cibomahto/Missing/Hardware/delrin gear settings.PNG

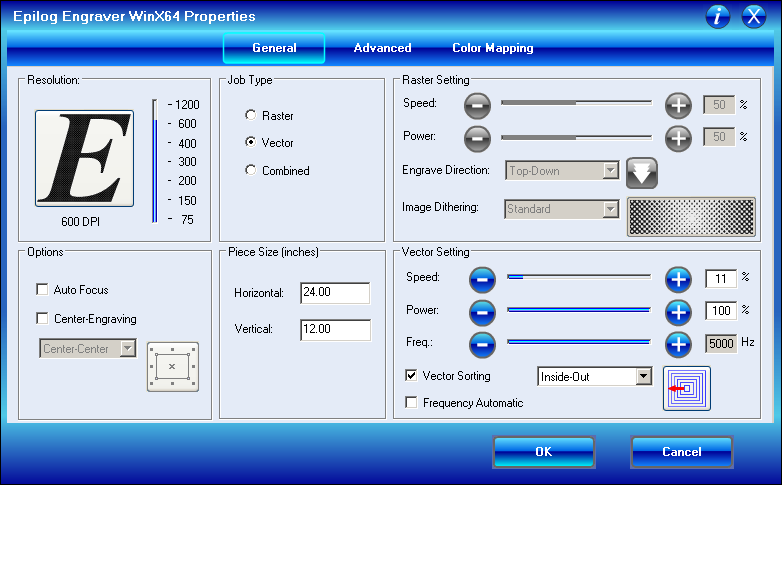
Hardware/delrin gear settings.PNG
