cibomahto/Missing/Hardware/triangle_mount_revB_grandlaser.pdf

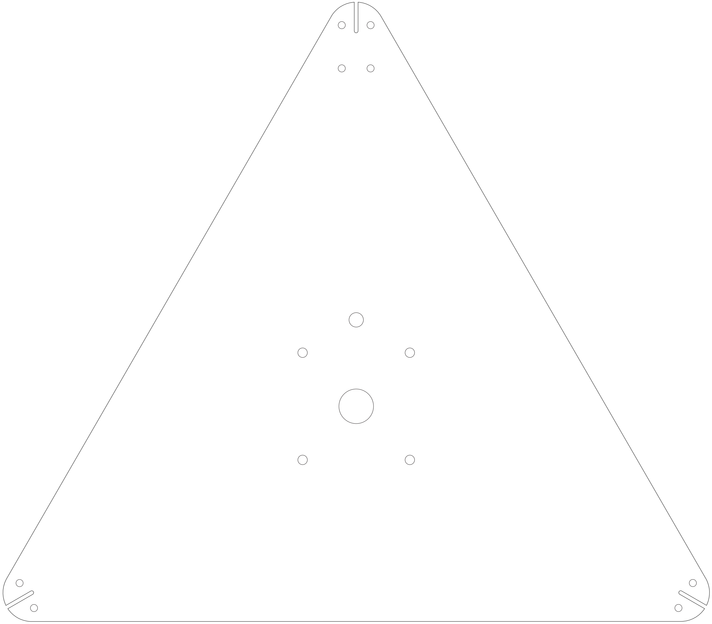
[picture p2: figure]
