cibomahto/Missing/motorControlPcb/motor control pcb stencil.pdf

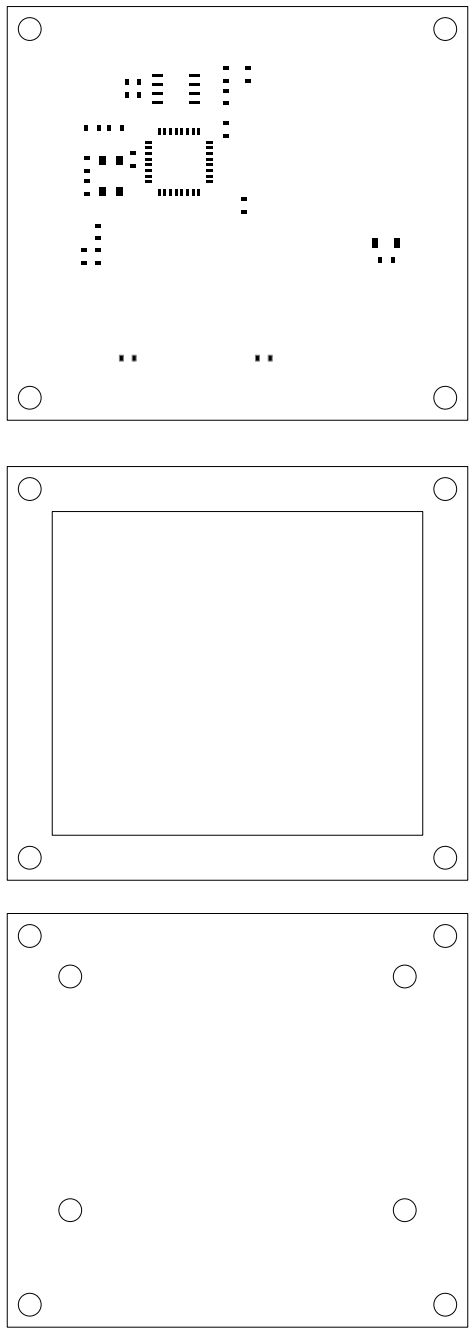
[picture p3: figure]
