cibomahto/Missing/Hardware/Concepts/Screen shot 2012-10-02 at 1.14.52 .png

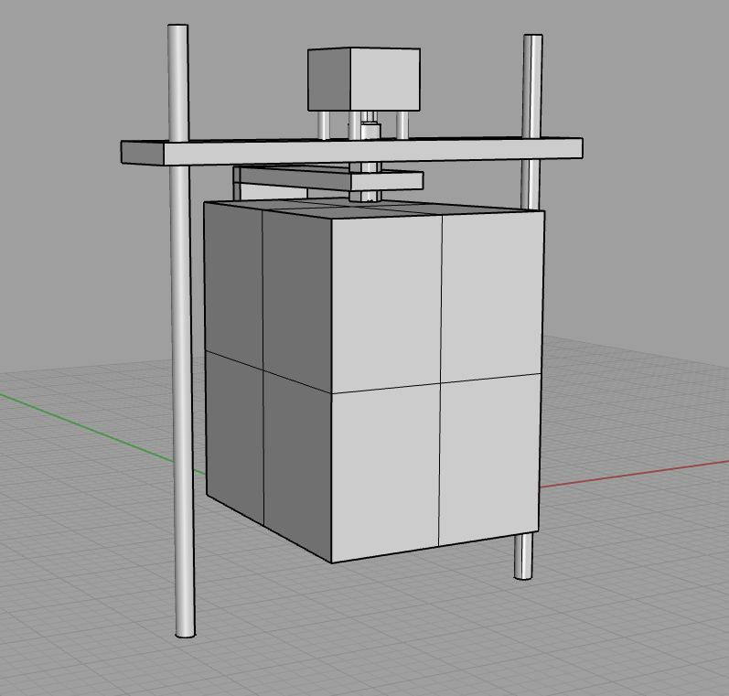
Hardware/Concepts/Screen shot 2012-10-02 at 1.14.52 .png
