cibomahto/Missing/Hardware/Concepts/Screen shot 2012-10-02 at 2.44.19 .png

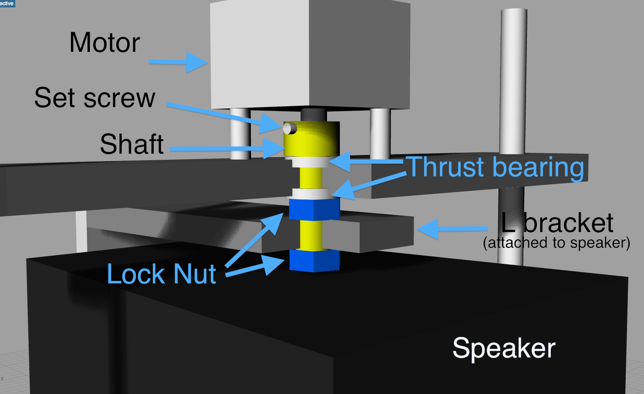
Hardware/Concepts/Screen shot 2012-10-02 at 2.44.19 .png
