cibomahto/Missing/Hardware/inventory.ods

Assembly | Part | per unit | total | Have?
Motor Unit | Stepper | 1 | 50 | Yes, 60 | x
 | Pot | 1 | 50 | Yes, 60 | x
 | Pot nut | 1 | 50 | Yes, 60 | x
 | Motor mount plate | 1 | 50 | Yes, 55+ | x
 | coupler | 1 | 50 | Yes, 60 | x
 | motor gear | 1 | 50 | Yes, 60 | x
 | pot gear | 1 | 50 | Yes, 60 | x
 | 8/32 standoff, 1” | 4 | 200 | Yes, 200+ | x
 | 8/32 bolt, .5” | 4 | 200 | Yes, 200+ | x
 | pot wire | 1 | 50 |  | x
 | pot heatshrink | 1 | 50 |  | x
 | stepper heatshrink | 1 | 50 |  | x
 | zip tie | 1 | 50 | Yes 90+ | x
 | M3x8, gear to standoff | 1 | 50 | Yes 50 | x
 | M3x8, standoff to shaft | 1 | 50 | 30 need 50 | x
 | M3x12, standoff to motor | 1 | 50 | Yes 50 | x
 | M3x6, PCB mount | 4 | 200 | Yes, 200+ | x
 | M3 nut, motor to plate | 2 | 100 | Yes, 100+ | x
 |  |  | 0
 |  |  | 0
 |  |  | 0
 |  |  | 0
Speaker Mount | Alignment plate | 2 | 100 | Yes, 102
 | wire clip | 6 | 300 | Yes, 320
 | M3x22, clip to plate | 6 | 300 | Yes, 400
 | bearing | 2 | 100 | Yes, 100+
 | M8 x 55mm, shaft | 1 | 50 | Yes, 50
 | 8/32 bolt, 1”, plate to motor standoff | 4 | 200 | Yes, 200+
 | 1/4-20, 3/4”, mechanical stop | 1 | 50 | Yes 50+
 | 1/2-20, lock nut, mechanical stop | 1 | 50 | Yes 50+
 | M3 nut, clip to plate | 6 | 300 | Yes 300
 |  |  | 0
 |  |  | 0
 |  |  | 0
 |  |  | 0
 |  |  | 0
 |  |  | 0
 |  |  | 0
 |  |  | 0
 |  |  | 0
L bracket | 1/4-20, 3/4”, speaker mount | 1 | 50 |  | x
 | M8 nut | 2 | 100 | Yes, 150+
 | M8 washer | 2 | 100 | Yes, 100+
 | M3x12, speaker alignment | 2 | 100 | Yes 100+ | x
 | M3 nut, speaker alignment | 2 | 100 | Yes 100 | x
 | 1/4-20, 3/4”, mechanical stop | 1 | 50 | no need 50 | x
 | 1/2-20, lock nut, mechanical stop | 1 | 50 | Have 40 need 20 more | x
 |  |  | 0
 |  |  | 0
 |  |  | 0
 |  |  | 0
 |  |  | 0
 |  |  | 0
 |  |  | 0
