cibomahto/Missing/Hardware/Concepts/standoff.stl

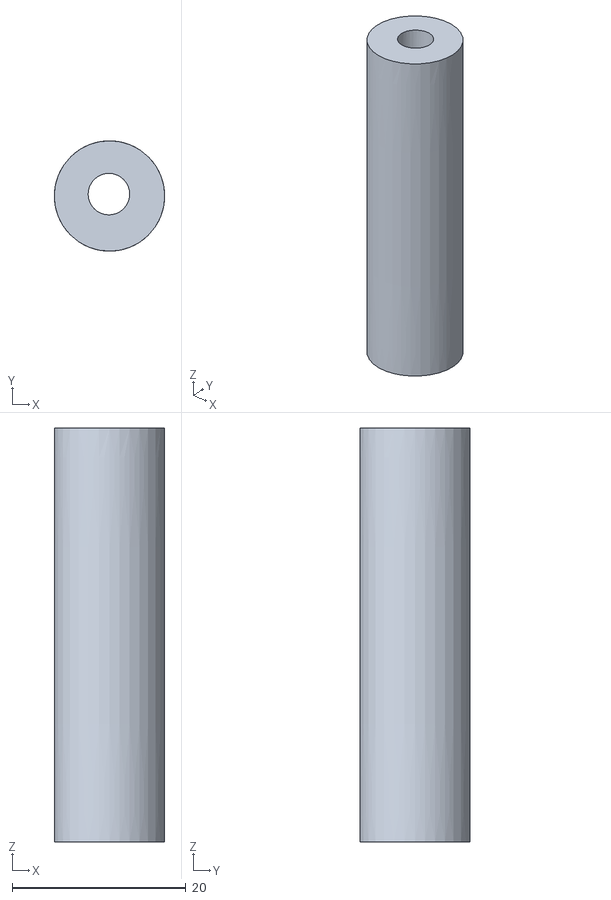
[picture p7: CAD file, 2012-11-15]
Hardware/Concepts/standoff.stl
12.7 x 12.7 x 47.6
