cibomahto/Missing/Hardware/Concepts/motor mount.stl

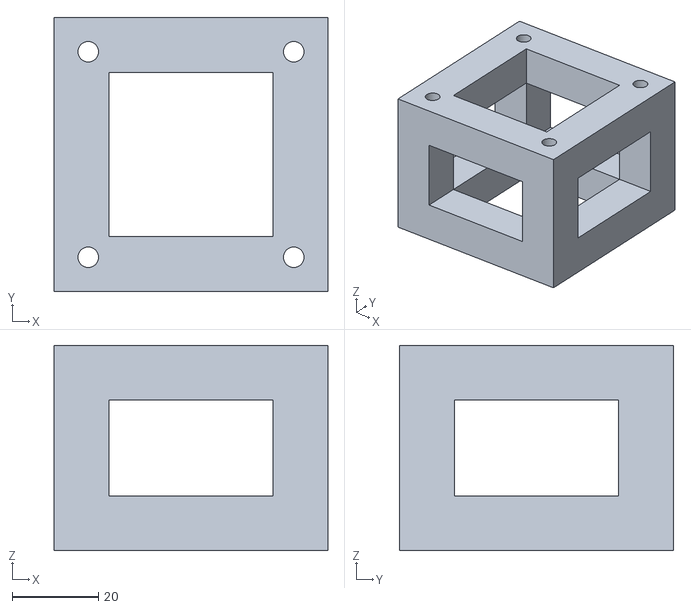
[picture p8: CAD file, 2012-10-04]
Hardware/Concepts/motor mount.stl
63.5 x 63.5 x 47.6
