cibomahto/Missing/MissingApp/bin/data/play3.obj

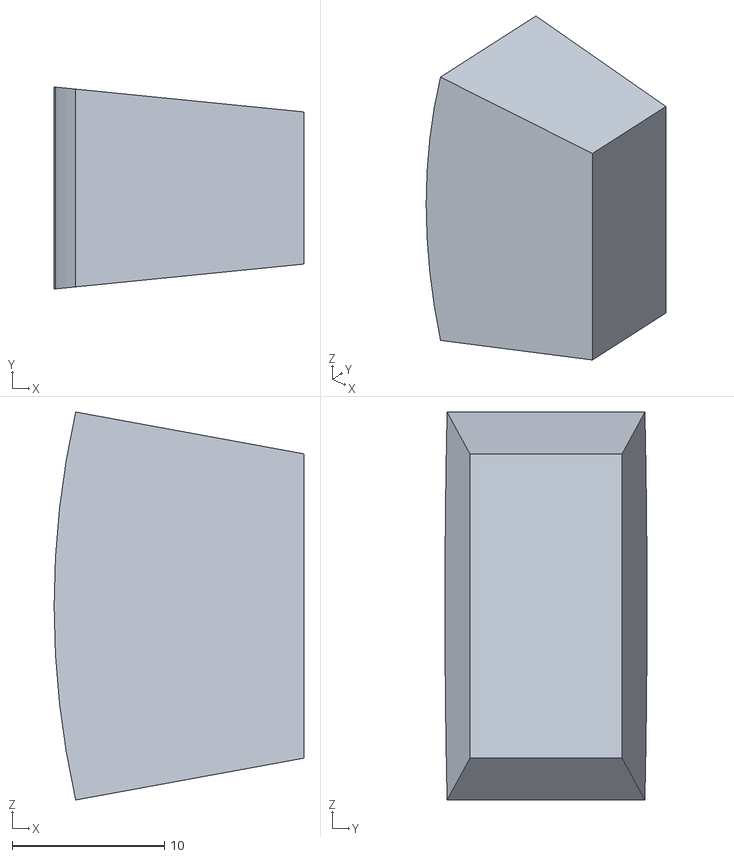
[picture p9: CAD file, 2012-11-11]
MissingApp/bin/data/play3.obj
16.4 x 13.3 x 25.5
