cibomahto/Missing/Hardware/Concepts/stepper_connector.stl

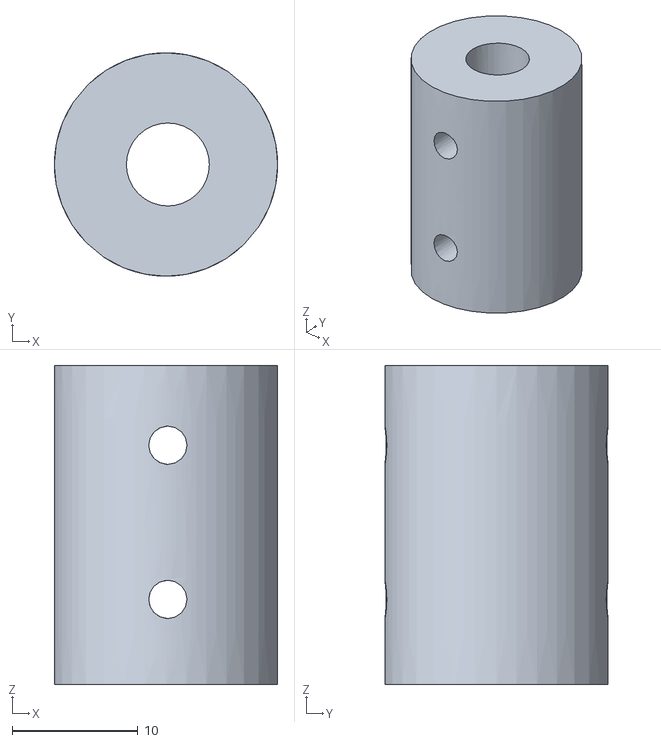
[picture p10: CAD file, 2012-10-04]
Hardware/Concepts/stepper_connector.stl
17.8 x 17.8 x 25.4
