cibomahto/Missing/(list of files, cad)

Other CAD files:
MissingApp/bin/data/centers.ply
MissingApp/bin/data/wires.ply
Hardware/Concepts/motor mount.3dm
Hardware/Concepts/sonos_speaker_mount.3dm
Hardware/Concepts/standoff.3dm
Hardware/Concepts/stepper_connector.3dm
Hardware/play3.3dm
Hardware/speaker_assembly.3dm
Hardware/triangle_mount.3dm
