cibomahto/Missing/Hardware/l_bracket_dimensions.pdf

# Sonos Speaker Mount Rev A - 10/13/2012

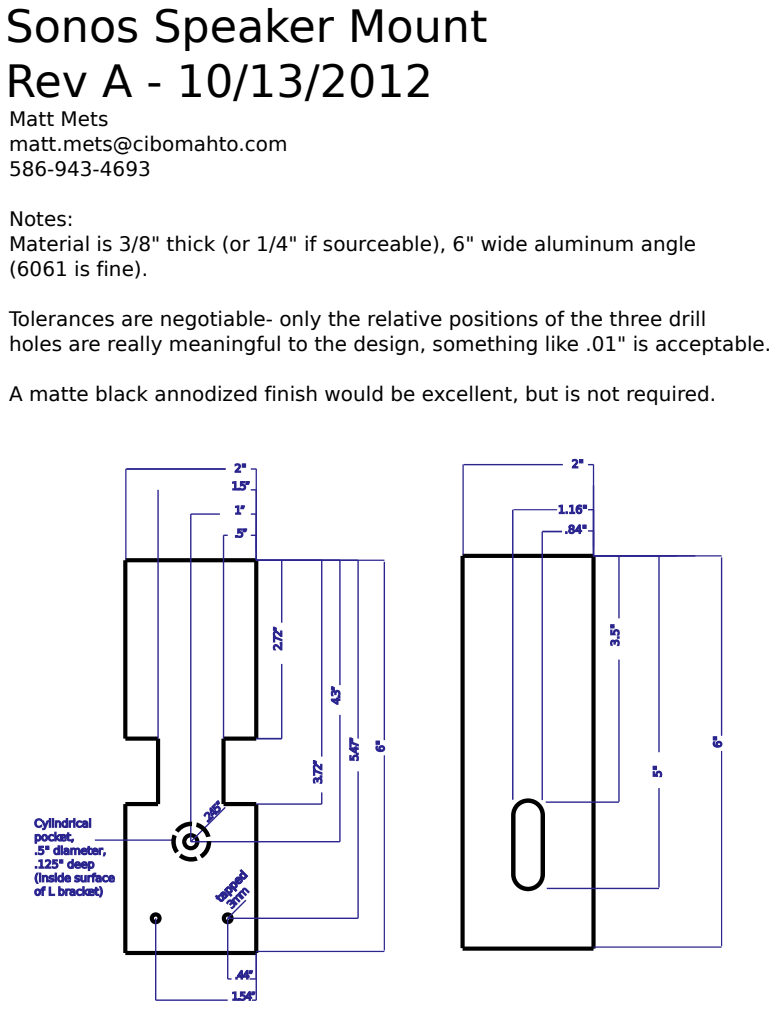
[picture p11: page 1]
Cylindrical pocket, .5" diameter, .125" deep (inside surface of L bracket)

Matt Mets
matt.mets@cibomahto.com

Notes:
Material is 3/8" thick (or 1/4" if sourceable), 6" wide aluminum angle
(6061 is fine).

Tolerances are negotiable- only the relative positions of the three drill
holes are really meaningful to the design, something like .01" is acceptable.

A matte black annodized finish would be excellent, but is not required.
