cibomahto/Missing/powerDistributionPcb/power distribution pcb stencil.pdf

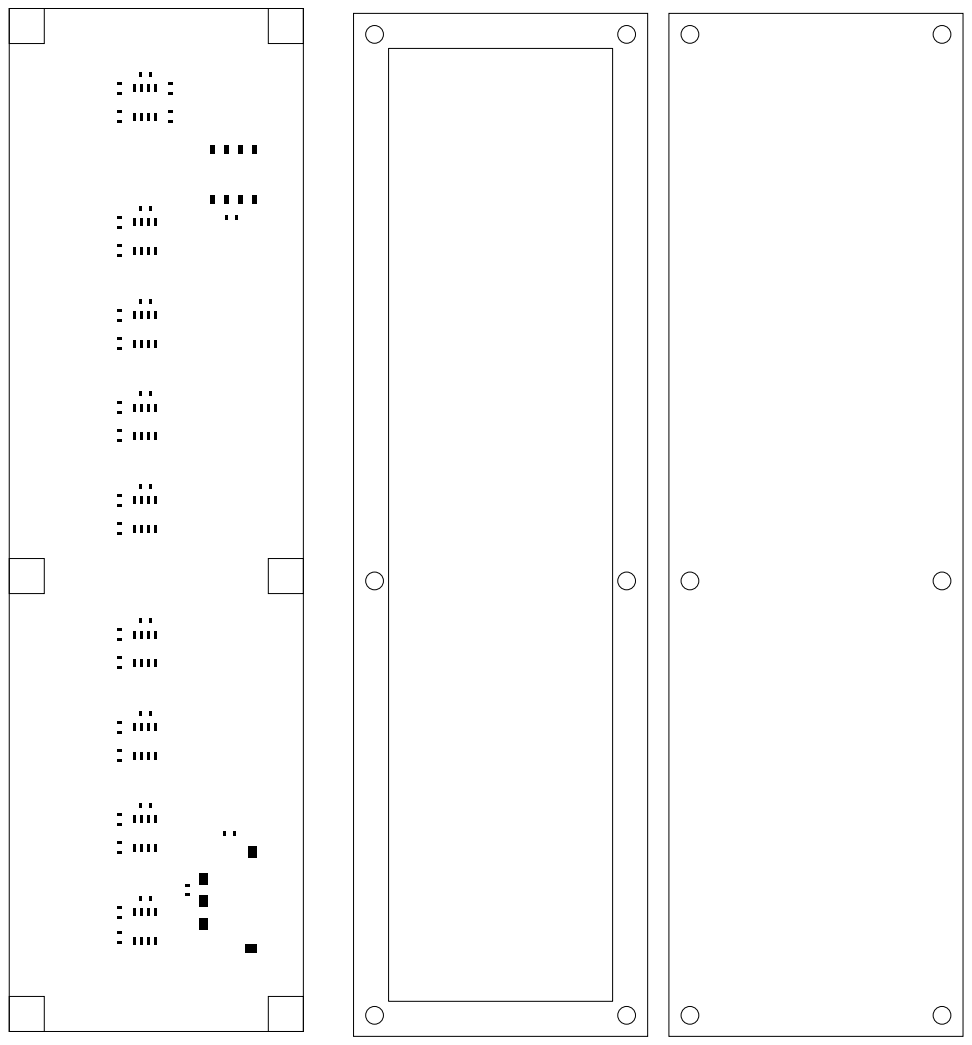
[picture p12: page 1]
