cibomahto/Missing/motorControlPcb/motor control pcb.brd

## EAGLE design motorControlPcb/motor control pcb.brd (2012-10-21)

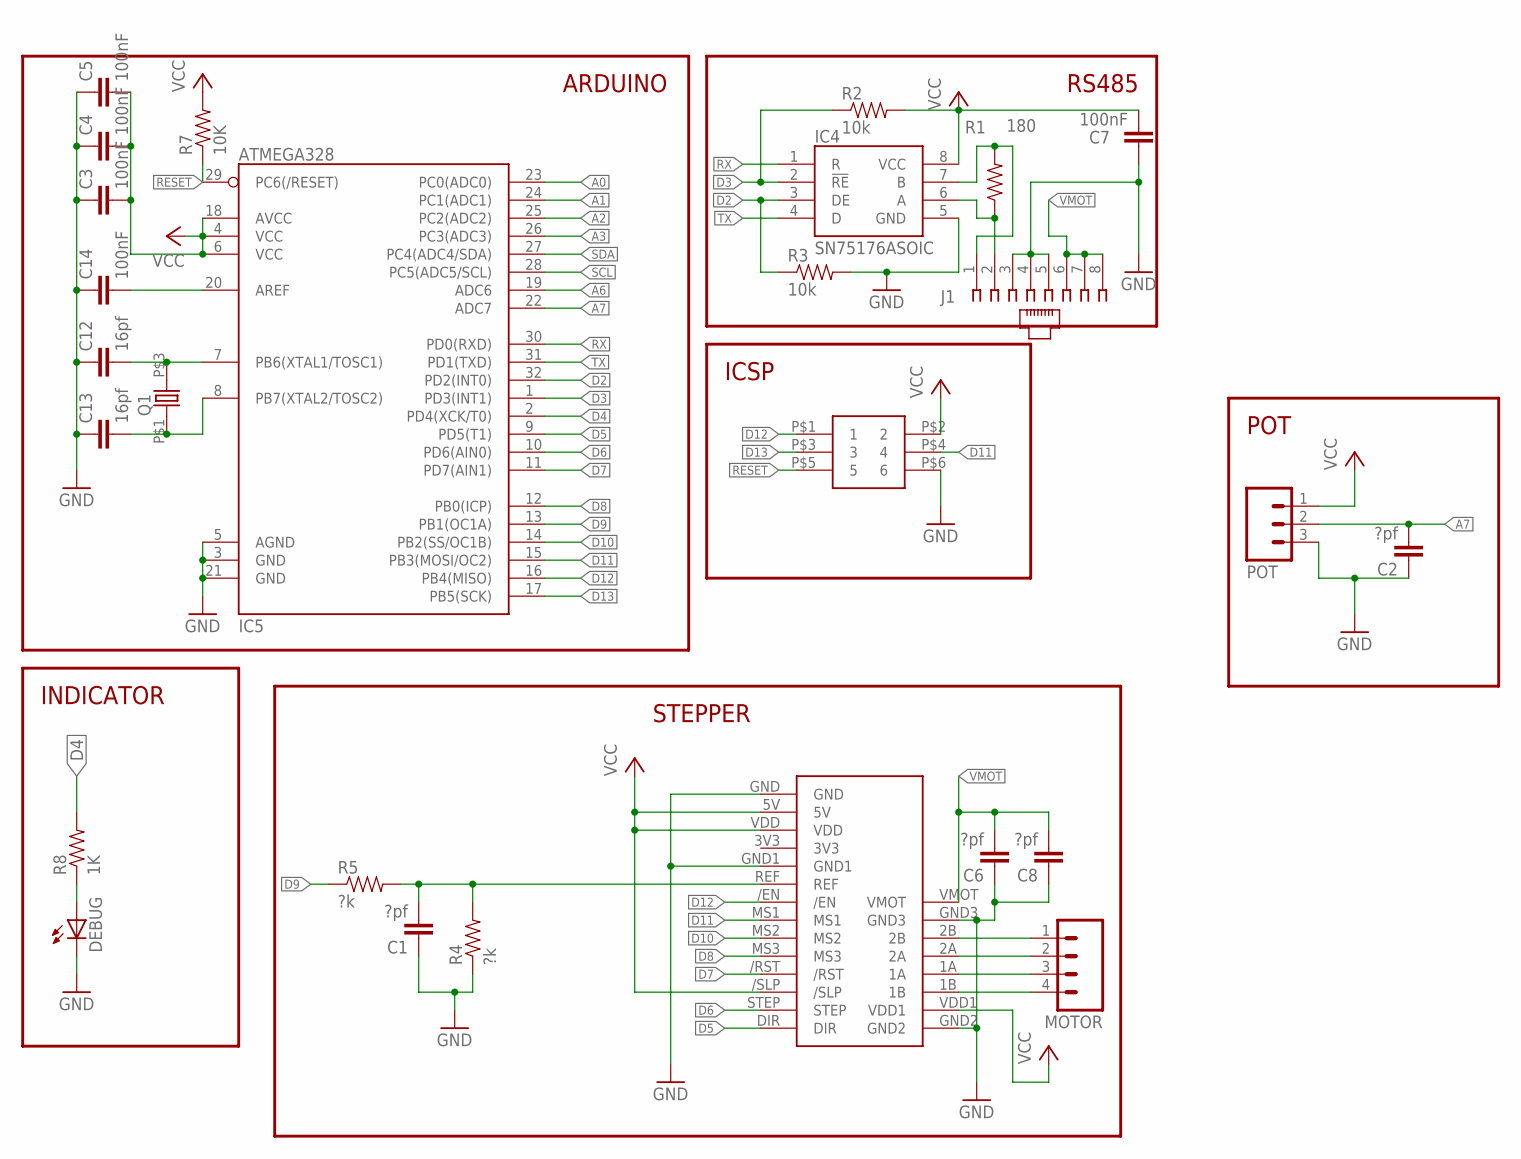
[picture p13: schematic motor control pcb.sch]

Parts:
C1, C2, C6: ?pf; 0805
C3, C4, C5, C7, C14: 100nF; 0805
C8: ?pf; 1210
C12, C13: 16pf; 0805
DEBUG: LED0805; LED-0805
IC4: SN75176ASOIC; SO08
IC5: ATMEGA328; TQFP32-08
J1: 520426-4
MOTOR: M04PTH; 1X04
POT: M03PTH; 1X03
Q1: GLOWBOARD_ABMM2; GLOWBOARD_ABMM2_CRYSTAL
R1: 180; 0805
R2, R3: 10k; 0805
R4, R5: ?k; 0805
R7: 10K; 0805
R8: 1K; 0805
U$1: POLOLU_DRIVER
U$2: 2X3HEADER

Connections:
A0: IC5.23 (PC0(ADC0))
A1: IC5.24 (PC1(ADC1))
A2: IC5.25 (PC2(ADC2))
A3: IC5.26 (PC3(ADC3))
A6: IC5.19 (ADC6)
A7: C2.2, IC5.22 (ADC7), POT.2
D2: IC4.3 (DE), IC5.32 (PD2(INT0)), R3.1
D3: IC4.2 (!RE), IC5.1 (PD3(INT1)), R2.1
D4: IC5.2 (PD4(XCK/T0)), R8.2
D5: IC5.9 (PD5(T1)), U$1.DIR
D6: IC5.10 (PD6(AIN0)), U$1.STEP
D7: IC5.11 (PD7(AIN1)), U$1./RST
D8: IC5.12 (PB0(ICP)), U$1.MS3
D9: IC5.13 (PB1(OC1A)), R5.1
D10: IC5.14 (PB2(SS/OC1B)), U$1.MS2
D11: IC5.15 (PB3(MOSI/OC2)), U$1.MS1, U$2.P$4 (4)
D12: IC5.16 (PB4(MISO)), U$1./EN, U$2.P$1 (1)
D13: IC5.17 (PB5(SCK)), U$2.P$3 (3)
GND: C1.1, C2.1, C3.1, C4.1, C5.1, C6.1, C7.1, C8.1, C12.1, C13.1, C14.1, DEBUG.C, IC4.5 (GND), IC5.3 (GND), IC5.5 (AGND), IC5.21 (GND), J1.3, J1.4, J1.5, POT.3, R3.2, R4.1, U$1.GND, U$1.GND1, U$1.GND2, U$1.GND3, U$2.P$6 (6)
unnamed: MOTOR.1, U$1.2B
unnamed: MOTOR.2, U$1.2A
unnamed: MOTOR.3, U$1.1A
unnamed: MOTOR.4, U$1.1B
unnamed: C13.2, IC5.8 (PB7(XTAL2/TOSC2)), Q1.P$1 (1)
unnamed: DEBUG.A, R8.1
unnamed: C1.2, R4.2, R5.2, U$1.REF
unnamed: C14.2, IC5.20 (AREF)
unnamed: C12.2, IC5.7 (PB6(XTAL1/TOSC1)), Q1.P$3 (2)
RESET: IC5.29 (PC6(/RESET)), R7.1, U$2.P$5 (5)
RS485A: IC4.6 (A), J1.2, R1.1
RS485B: IC4.7 (B), J1.1, R1.2
RX: IC4.1 (R), IC5.30 (PD0(RXD))
SCL: IC5.28 (PC5(ADC5/SCL))
SDA: IC5.27 (PC4(ADC4/SDA))
TX: IC4.4 (D), IC5.31 (PD1(TXD))
VCC: C3.2, C4.2, C5.2, C7.2, IC4.8 (VCC), IC5.4 (VCC), IC5.6 (VCC), IC5.18 (AVCC), POT.1, R2.2, R7.2, U$1.5V, U$1./SLP, U$1.VDD, U$1.VDD1, U$2.P$2 (2)
VMOT: C6.2, C8.2, J1.6, J1.7, J1.8, U$1.VMOT

Notes on the sheet:
RS485
ICSP
ARDUINO
INDICATOR
STEPPER
POT

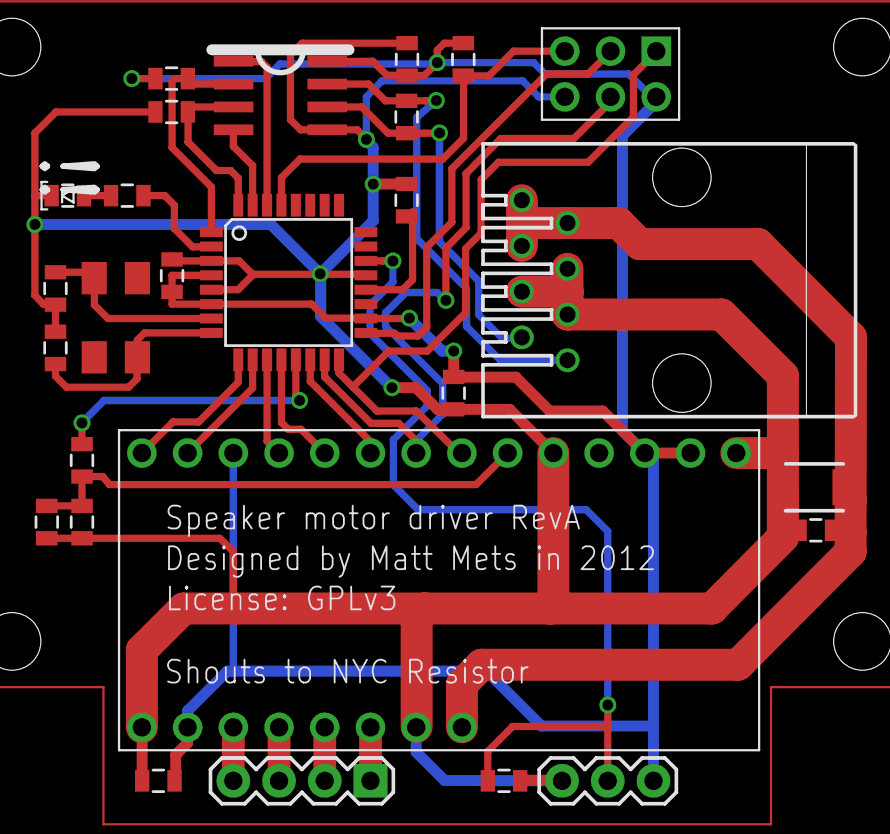
[picture p14: board motor control pcb.brd from above]

Board: 2 copper layers, 27 parts (0 on the bottom side), 30 nets.
