cibomahto/Missing/StepperFirmware/defines.h

#ifndef _DEFINES_h
#define _DEFINES_h

#define R_ENABLE_PIN    2
#define D_ENABLE_PIN    3

#define LED_PIN         4

#define POSITION_INPUT  7

#define MS1_PIN         11
#define MS2_PIN         10
#define MS3_PIN         8
#define RESET_PIN       7
#define ENABLE_PIN      12
#define STEP_PIN        6
#define DIR_PIN         5

#define CURRENT_REF_PIN 9

#endif
