cibomahto/Missing/MissingApp/src/MiniFont.h

#pragma once

#include "ofMain.h"

namespace MiniFont {
	void updateProjectionState();
	ofVec3f ofWorldToScreen(ofVec3f world);
	void setup();
	void draw(string str, float x, float y);
	void drawScreen(string str, ofVec3f position);
}
