cibomahto/Missing/(commit log)

2012-10-02 Initial hardware design.
    [sonos_speaker_mount.3dm]
2012-10-03 Add lasercut files for 1/4 inch acryllic.
2012-10-04 Add protoypes for motor mount, shaft coupler.
    [motor mount.3dm, motor mount.stl, stepper_connector.3dm, stepper_connector.stl]
2012-10-09 Add test program for stepper control.
2012-10-09 Lasercut plan for the stepper mount
2012-10-10 first pass at a servo loop. for demonstration only.
2012-10-10 Add Rhino model of speaker mount; still a wip
    [speaker_assembly.3dm]
2012-10-11 Add l-bracket mechanicals
2012-10-11 Switch to a different pot, add space for PCB
2012-10-12 Pull in MB extruder controller, as base for motor control pcb
    [motor control pcb.brd, motor control pcb.sch]
2012-10-12 Motor control PCB
    [motor control pcb.brd, motor control pcb.sch]
2012-10-14 added play3 model and triangle mount
    [play3.3dm, triangle_mount.3dm]
2012-10-14 wip on wiring
2012-10-15 Make the motor control more fancy.
2012-10-15 updated with total power
2012-10-15 Add revised triangle mount. Tested using 1/8" acrylic, and submitted for quotes.
    [triangle_mount_revA.dxf]
2012-10-15 Bump motor plate to revA, changed gear size to match new steppers.
2012-10-16 Rev 0 of the motor control pcb; update for smaller traces.
    [motor control pcb.brd, motor control pcb.sch]
2012-10-16 Add PCB libraries
2012-10-16 Make board outline 2"x2"; need to center or make smaller.
    [motor control pcb.brd]
2012-10-17 Update board again.
    [motor control pcb.brd]
2012-10-17 Rearrange things.
    [motor control pcb.brd, motor control pcb.sch]
2012-10-18 Board layout finished, need verification
    [motor control pcb.brd, motor control pcb.sch]
2012-10-18 Finish laying out and verifying board. Bugfix: don't pull /sleep low.
    [motor control pcb.brd, motor control pcb.sch]
2012-10-19 Motor control board Rev A, final.
    [motor control pcb.brd, motor control pcb.sch]
2012-10-19 Motor plate Rev B (includes PCB mount)
2012-10-19 Get rid of unused hardware revs.
    [triangle_mount_revA.dxf]
2012-10-21 added stepper simulation that should help a lot with debugging acceleration logic
2012-10-22 added better stepper code to simulation that deals with acceleration/deceleration nicely
2012-10-22 tried to fix name
    [StepperFirmware.ino]
2012-10-22 new stepper patterns
2012-10-22 all updated code for arduino and pde
2012-10-26 initial tracker just doing background calibration
2012-10-26 next step is getting the cloud aligned a la ofxVirtualKinect
2012-10-26 Add power distribution pcb.
    [power distribution pcb.brd, power distribution pcb.sch]
2012-10-31 Update firmware for actual PCB.
2012-11-02 Update lasercut versions.
2012-11-02 Add design files for power distribution board
    [power distribution pcb.brd, power distribution pcb.sch]
2012-11-04 Add gerbers for the PCBs
2012-11-04 Add solder stencil design for the motor control board
2012-11-04 Iterate on the motor plate a bit more (TODO: gear spacing still incorrect)
2012-11-09 position data and play3 3d model
    [centers.ply, play3.obj, wires.ply]
2012-11-10 xcode 4, driverinterface
2012-11-12 filtering kinect data
2012-11-13 moved KinectFilter to MissingTracker
    [KinectFilter.h, main.cpp]
2012-11-13 Update speaker motor controller
2012-11-13 Rename motor controller
2012-11-14 much better tracking, fixed bug with stretchy mesh
    [KinectFilter.h, KinectTracker.h, main.cpp]
2012-11-15 added export and center
    [positions.csv]
2012-11-15 refactoring to simplify controlp5 usage
    [positions.csv]
2012-11-15 save calibration data
2012-11-15 calibration sliders fixed to ends
2012-11-15 added calibration data
2012-11-15 made data safe, fixed some weird angular representation
    [DriverInterface.h, Speaker.cpp, Speaker.h]
2012-11-15 renamed before combining
    [centers.ply, play3.obj, wires.ply]
2012-11-15 Move shit.
    [motor mount.3dm, motor mount.stl, sonos_speaker_mount.3dm, standoff.3dm, standoff.stl, stepper_connector.3dm, stepper_connector.stl]
2012-11-15 Add production files for lasercut hardware
    [inventory.ods]
2012-11-15 Add final solder stencils
2012-11-15 Rename more stuff.
    [motor control pcb.brd, motor control pcb.sch, power distribution pcb.brd, power distribution pcb.sch]
2012-11-15 combined missing app
    [centers.ply, heights.csv, play3.obj, wires.ply]
2012-11-15 updated debugger, working towards final fixes to main app
    [MissingApp.cpp, speakerMotorDebugger.pde]
2012-11-16 updated calibration
2012-11-16 better calibration
2012-11-16 more calibration timing updates
2012-11-16 better calibration routine, more sound control
2012-11-19 Add power distribution box plans, courtesy Max
2012-11-19 Remove duplicate solder stencil file.
2012-12-04 Add license info for PCBs and firmware.
2012-12-09 updated calibration with reduced min on speaker 0
