cibomahto/Missing/(notices)

Notices in the files:
powerDistributionPcb/power distribution pcb.brd:
License: GPLv3
